JoonSJPK/analog_NN/dig_ana_sim_out/analog_NN_cross_domain_report.html

# analog_NN — simulation report

## Project Overview & Topology

Project | analog_NN
Components | 241 total (29 analog-bound, 64 AD5160, 53 resistors, 8 74HC595, 1 RP2040)
Nets | 194
Power rails | VCC=3.3 V, Vref=1.65 V (virtual ground)

## Firmware (RP2040)

Status | SKIPPED
Reason | No firmware ELF provided. User must supply a compiled RP2040 binary to run on Renode.
Note | Without firmware the shift chain and pot codes are set to defaults (code 128).

## Digital Domain — 74HC595 Shift Chain

Test | Shift 8 ones through 74HC595 cascade
Signals tracked | 277
Outputs asserted high | 49
Interpretation | Shift chain is connected and functional; 49 outputs assert from 8 bits shifted through a multi-stage serial-to-parallel topology.

## Analog Domain — Static Operating Point (.op) PASS

Analysis | .op
Converged | Yes
Pots modeled | 64 (AD5160 default code=128)
VCC | 3.30 V
Vref | 1.65 V
Status | Board biases correctly at mid-rail virtual ground.

## Analog Domain — Transient (.tran 100µ 5ms) PASS

Analysis | .tran 100u 5m
Converged | Yes
Duration | 5 ms simulated
Status | Full-board transient simulation converged cleanly.

## MVM Primitive Verification — Linear Range PASS

Test 1 (codes [120,200,64], inputs [1.8,1.5,1.7]) | Ideal=1.3293 V, SPICE=1.3292 V, error=0.11 mV, NOT clamped
Test 2 (codes [180,90,32], inputs [1.6,1.7,1.55]) | Ideal=2.344 V, SPICE=2.3437 V, error=0.30 mV, NOT clamped
Conclusion | Sub-millivolt accuracy when operating within linear range (mid codes ~32-224, inputs within ~0.3 V of 1.65 V virtual ground).
Status | Analog MVM primitive matches numpy ideal to < 1 mV.

## MVM Primitive — Intentional Clamping Check PASS

Test (codes [0,5,10], inputs [0.1,0.1,0.1]) | Ideal=355.09 V (unbounded), SPICE=3.2536 V (clamped), error=31.4 mV, CLAMPED=true
Interpretation | Code 0 = 60 Ω minimum resistance creates large current; 0.1 V input far from 1.65 V virtual ground forces rail-to-rail saturation. This is expected op-amp clamping, NOT a defect.
Notes | The TLV9061 output naturally saturates near the supply rails for extreme conductance or input-deviation combinations. For valid analog compute, keep codes in 32-224 and inputs within 0.3 V of Vref.
