JoonSJPK/analog_NN/dig_ana_sim_out/analog_NN_multidomain_report.html

# analog_NN — simulation report

## Project Discovery

Board | analog_NN
Components | 241 (64 AD5160 pots, 29 TLV9061 op-amps, 8×74HC595, 1 RP2040)
Nets | 194
Analog (bound) | 29 TLV9061 op-amps
Analog (unmodeled) | 64 AD5160 pots, 53 resistors, 82 caps, etc.
Digital | 8× 74HC595 shift registers
Firmware | RP2040 (U40)

## Digital Shift Chain (74HC595) PASS

Test | Shift 8 ones through 8× 74HC595
Total outputs | 277
Outputs high | 49
Verdict | Shift chain functional

## Firmware (RP2040) FAIL

Target | U40 (RP2040)
ELF | firmware/analog_NN.elf
Status | TIMEOUT after 300 s — Renode environment or ELF path issue
Recommendation | Verify ELF path, renode .resc script, and machine definition

## Analog Board (ngspice .tran) PASS

Analysis | .tran 1u 2m, default_code=128
Converged | Yes
VCC | 3.3 V
Vref | 1.65 V
Pots modeled | 64 (all)

## MVM Crossbar Verification (AD5160 + TLV9061 TIA) FAIL

Test 1 — codes=[128,128,128,128], Vin=[0.5,0.5,0.5,0.5] | Ideal=10.74 V, Clamped ideal=3.285 V, SPICE=3.2605 V, err=24.5 mV → CLAMPED
Test 2 — codes=[64,64,64,64], Vin=[0.2,0.2,0.2,0.2] | Ideal=24.31 V, Clamped=3.285 V, SPICE=3.256 V, err=28.7 mV → CLAMPED
Test 3 — codes=[200,50,200,50], Vin=[0.3,0.7,0.3,0.7] | Ideal=14.52 V, Clamped=3.285 V, SPICE=3.261 V, err=24.5 mV → CLAMPED
Test 4 — codes=[255,0,255,0], Vin=[0.1,1.0,0.1,1.0] | Ideal=221.4 V, Clamped=3.285 V, SPICE=3.262 V, err=22.6 mV → CLAMPED
Test 5 — codes=[16,16,16,16], Vin=[0.05,0.05,0.05,0.05] | Ideal=95.1 V, Clamped=3.285 V, SPICE=3.254 V, err=31.5 mV → CLAMPED
Test 6 — codes=[1], Vin=[0.001] | Ideal=168.1 V, Clamped=3.285 V, SPICE=3.253 V, err=32.2 mV → CLAMPED
Test 7 — codes=[0], Vin=[0.5] | Ideal=193.3 V, Clamped=3.285 V, SPICE=3.258 V, err=27.4 mV → CLAMPED

## Diagnosis: Pervasive Op-Amp Clipping FAIL

Observation | Every tested (codes, Vin) combination produces Vout ≈ 3.25-3.26 V — the TLV9061 positive rail (3.3 V) with ~50 mV headroom.
Root cause | The TIA feedback resistor (Rf) is extremely large relative to the AD5160 wiper resistance (Rw). Even Rw_min (code=0) with Vin=1 mV produces an ideal output >160 V, far exceeding the 3.3 V supply.
Implication | The crossbar operates in hard saturation for ALL practical inputs. The MVM is non-functional as a linear computation — it only outputs rail voltage.
Fix needed | Reduce Rf by 100–1000×, or reduce input voltage range, or increase VCC (TLV9061 supports up to 5.5 V) but fundamental gain is still too high.
