JoonSJPK/analog_NN/dig_ana_sim_out/report.html

# analog_NN — simulation report

## Design

components | 241
nets | 194
analog op-amps (modeled) | 29
analog unmodeled (pots etc.) | 67
digital ICs | 9
firmware (MCU) | U40

## Analog (ngspice, full board) PASS

pots modeled | 64
converged | True
vcc | 3.3
vref | 1.65

## Digital (Icarus Verilog, 74HC595 chain) PASS

signals | 277
outputs asserted | 238

## Analog compute vs numpy ideal (MVM) PASS

ideal | 1.3293
spice | 1.3292
error (mV) | 0.11
