JoonSJPK/analog_NN/analog_NN_JLCPCB_BOM.csv

Comment | Designator | Footprint | JLC_Class | LCSC_Candidate_VERIFY | Notes
100nF 50V X7R | C1,C2,C3,C4,C5,C6,C7,C8,C9,C10,C11,C12,C13,C14,C15,C16,C17,C18,C19,C20,C21,C22,C23,C24,C25,C26,C27,C28,C29,C30,C31,C32,C33,C34,C35,C36,C37,C38,C39,C40,C41,C42,C43,C44,C45,C46,C47,C48,C49,C50,C51,C52,C53,C54,C55,C56,C57,C58,C59,C60,C61,C62,C63,C64,C65,C66,C67,C68,C70 | C1206 | Basic | C29823 | Verify: 1206 100nF X7R Basic part
1uF 25V X7R | C69 | C1206 | Basic | C15849 | Verify 1206 1uF X7R
10k 1% | R1,R2,R3,R4,R5,R6,R7,R8,R9,R10,R11,R12,R13,R14,R15,R16,R17,R18,R19,R20,R21,R22,R23,R24,R25,R26,R27,R28,R29,R30,R31,R32,R33,R34,R35,R36,R37,R38,R39,R40,R41,R42,R43,R48,R49 | R1206 | Basic | C17888 | Verify 1206 10k 1%
10M 1% | R44,R45,R46,R47 | R1206 | Basic | C112094 | Verify 1206 10M 1%
TLV9061IDBVR | U1,U3,U4,U5,U6,U7,U8,U9,U10,U11,U12,U13,U14,U15,U16,U17,U18,U19,U20,U21,U22,U23,U24,U25,U26,U27,U43,U132 | SOT-23-5 | Extended | C398358 | VERIFIED in stock. 29 pcs. NOTE: 27 have blank value in sch (U1-U27) - set to TLV9061IDBVR
AD5160BRJZ10-RL7 | U28,U29,U30,U31,U32,U33,U34,U35,U60,U61,U62,U63,U64,U65,U66,U67,U68,U69,U70,U71,U72,U73,U74,U75,U76,U77,U78,U79,U80,U81,U82,U83,U100,U101,U102,U103,U104,U105,U106,U107,U108,U109,U110,U111,U112,U113,U114,U115,U116,U117,U118,U119,U120,U121,U122,U123,U124,U125,U126,U127,U128,U129,U130,U131 | SOT-23-8 | Extended | C40097 | VERIFIED ~5295 in stock (~$1.37). 10k variant. 100k variant = C578141. 64 pcs/board
SN74HC595DR | U36,U37,U38,U39,U93,U94,U95,U96 | SOIC-16 | Basic | C5947 | VERIFIED Basic (Nexperia 74HC595D). TI SN74HC595DR = C10092
