JoonSJPK/analog_NN/dig_ana_sim_out/netlist/analog_NN.cir

.title KiCad schematic
.include "/Users/joon/Projects/Wim/analog_NN/TLV9061_generic.lib"
C78 Net-_U42-EN_ GND 10u
U42 __U42
J1 __J1
R48 Net-_J1-CC1_ GND 5.1k
R49 Net-_J1-CC2_ GND 5.1k
C80 Net-_U42-EN_ GND 1u
C81 GND VREF 10u
U40 __U40
R51 Net-_C75-Pad1_ Net-_U40-XOUT_ 1k
Y1 __Y1
C75 Net-_C75-Pad1_ GND 15p
XU2 VREF GND Net-_U2-+_ VREF VCC TLV9061
C70 GND VCC 100n
U41 __U41
C76 Net-_U40-XIN_ GND 15p
R53 Net-_U2-+_ GND 10k
C77 Net-_U42-BP_ GND 470p
C79 VCC GND 10u
C82 GND Net-_U2-+_ 100n
R52 VCC Net-_U2-+_ 10k
C69 GND Net-_U40-VREG_VOUT_ 1u
R50 Net-_U40-RUN_ VCC 10k
C72 GND VCC 100n
C71 GND VCC 100n
C73 GND VCC 100n
C74 GND VCC 100n
R12 Net-_U6--_ Vh3 10k
XU7 -Vh4 GND VREF Net-_U7--_ VCC TLV9061
R14 Net-_U7--_ Vh4 10k
R13 -Vh4 Net-_U7--_ 10k
XU6 -Vh3 GND VREF Net-_U6--_ VCC TLV9061
XU4 -Vh1 GND VREF Net-_U4--_ VCC TLV9061
XU3 -Vu3 GND VREF Net-_U3--_ VCC TLV9061
R6 Net-_U3--_ Vin_u3 10k
R7 -Vh1 Net-_U4--_ 10k
R5 -Vu3 Net-_U3--_ 10k
R8 Net-_U4--_ Vh1 10k
R2 Net-_U1--_ Vin_u2 10k
R1 -Vu2 Net-_U1--_ 10k
XU43 -Vu1 GND VREF Net-_U43--_ VCC TLV9061
R3 -Vu1 Net-_U43--_ 10k
XU1 -Vu2 GND VREF Net-_U1--_ VCC TLV9061
R4 Net-_U43--_ Vin_u1 10k
R11 -Vh3 Net-_U6--_ 10k
XU5 -Vh2 GND VREF Net-_U5--_ VCC TLV9061
R10 Net-_U5--_ Vh2 10k
R9 -Vh2 Net-_U5--_ 10k
C22 VCC GND 100n
U77 __U77
U73 __U73
U72 __U72
C19 VCC GND 100n
C20 VCC GND 100n
C28 VCC GND 100n
U76 __U76
C21 VCC GND 100n
U80 __U80
C27 VCC GND 100n
U81 __U81
C15 VCC GND 100n
U70 __U70
C10 VCC GND 100n
U66 __U66
C7 VCC GND 100n
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
U30 __U30
U29 __U29
C61 VCC GND 100n
C68 VCC GND 100n
U28 __U28
C64 VCC GND 100n
C65 VCC GND 100n
U35 __U35
XU92 torque GND VREF Net-_U28-A_ VCC TLV9061
R43 Net-_U28-A_ torque 10k
C63 VCC GND 100n
U32 __U32
U37 __U37
U38 __U38
U39 __U39
U36 __U36
U93 __U93
U94 __U94
U95 __U95
U96 __U96
.end
