JoonSJPK/analog_NN/analog_NN.kicad_pcb

## KiCad design analog_NN.kicad_pcb (2026-08-01)

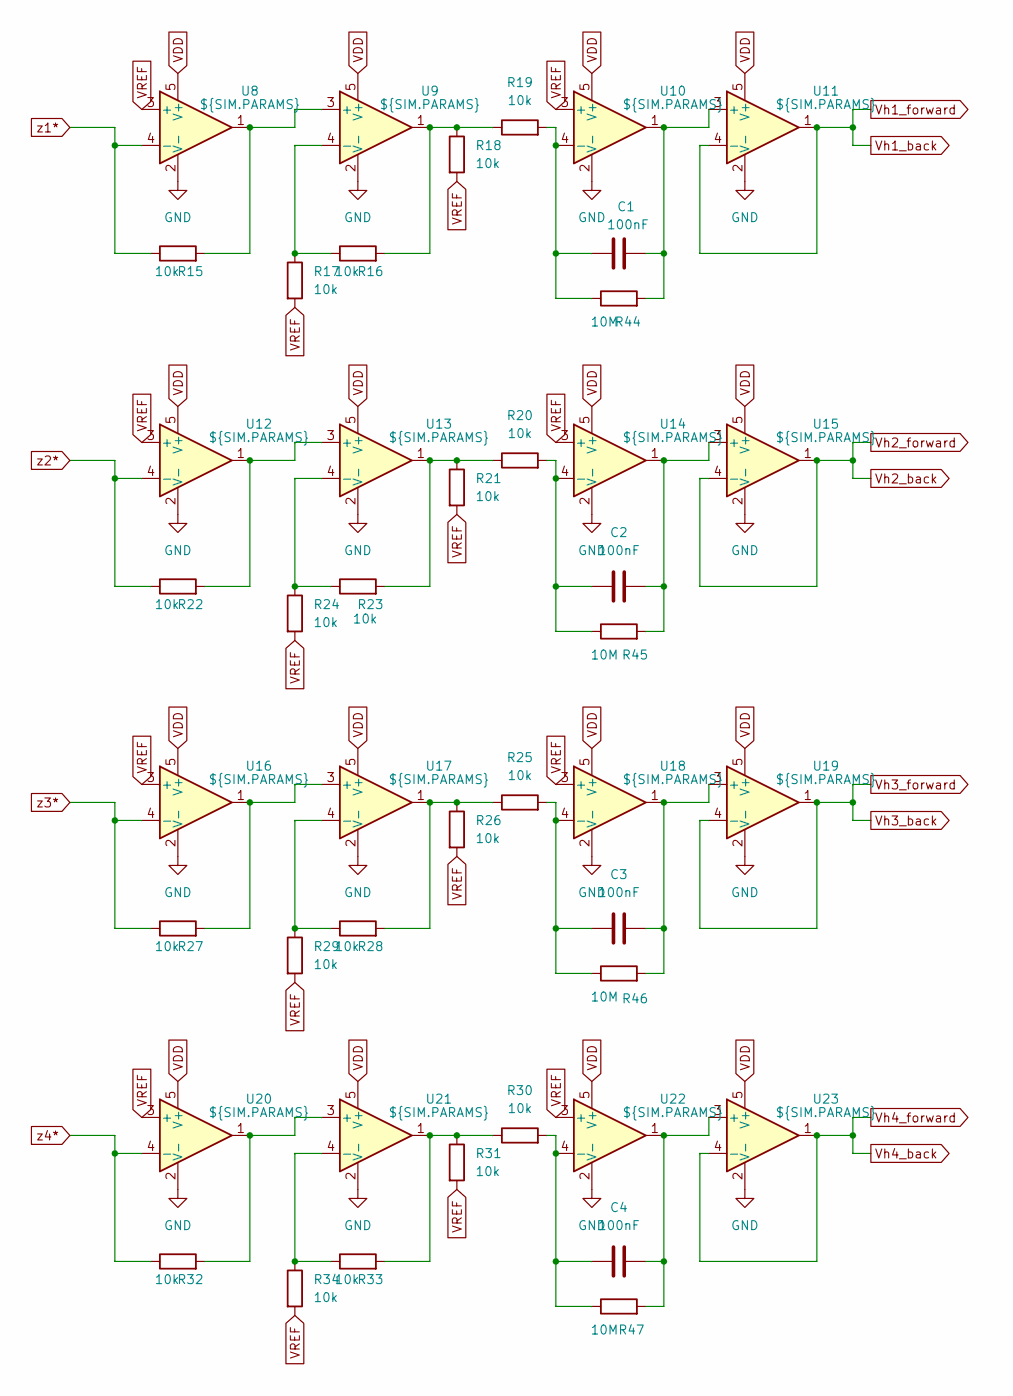
[picture p1: schematic op_amps.kicad_sch]

Parts:
C1, C2, C3, C4: 100nF; C_1206_3216Metric
R15, R16, R17, R18, R19, R20, R21, R22, R23, R24, R25, R26, R27, R28, R29, R30, R31, R32, R33, R34: 10k; R_1206_3216Metric
R44, R45, R46, R47: 10M; R_1206_3216Metric
U8, U9, U10, U11, U12, U13, U14, U15, U16, U17, U18, U19, U20, U21, U22, U23: ${SIM.PARAMS}; SOT-23-5

Connections:
GND: U8.2 (V-), U9.2 (V-), U10.2 (V-), U11.2 (V-), U12.2 (V-), U13.2 (V-), U14.2 (V-), U15.2 (V-), U16.2 (V-), U17.2 (V-), U18.2 (V-), U19.2 (V-), U20.2 (V-), U21.2 (V-), U22.2 (V-), U23.2 (V-); also elsewhere on the board
unnamed: R16.2, R18.1, R19.1, U9.1
unnamed: R20.1, R21.1, R23.2, U13.1
unnamed: R25.1, R26.1, R28.2, U17.1
unnamed: R30.1, R31.1, R33.2, U21.1
unnamed: R15.2, U8.1, U9.3 (+)
unnamed: R16.1, R17.1, U9.4 (-)
unnamed: C1.1, R19.2, R44.1, U10.4 (-)
unnamed: C1.2, R44.2, U10.1, U11.3 (+)
unnamed: R22.2, U12.1, U13.3 (+)
unnamed: R23.1, R24.1, U13.4 (-)
unnamed: C2.1, R20.2, R45.1, U14.4 (-)
unnamed: C2.2, R45.2, U14.1, U15.3 (+)
unnamed: R27.2, U16.1, U17.3 (+)
unnamed: R28.1, R29.1, U17.4 (-)
unnamed: C3.1, R25.2, R46.1, U18.4 (-)
unnamed: C3.2, R46.2, U18.1, U19.3 (+)
unnamed: R32.2, U20.1, U21.3 (+)
unnamed: R33.1, R34.1, U21.4 (-)
unnamed: C4.1, R30.2, R47.1, U22.4 (-)
unnamed: C4.2, R47.2, U22.1, U23.3 (+)
VDD: U8.5 (V+), U9.5 (V+), U10.5 (V+), U11.5 (V+), U12.5 (V+), U13.5 (V+), U14.5 (V+), U15.5 (V+), U16.5 (V+), U17.5 (V+), U18.5 (V+), U19.5 (V+), U20.5 (V+), U21.5 (V+), U22.5 (V+), U23.5 (V+); also elsewhere on the board
VREF: R17.2, R18.2, R21.2, R24.2, R26.2, R29.2, R31.2, R34.2, U8.3 (+), U10.3 (+), U12.3 (+), U14.3 (+), U16.3 (+), U18.3 (+), U20.3 (+), U22.3 (+); also elsewhere on the board
Vh1: U11.1, U11.4 (-); also elsewhere on the board
Vh2: U15.1, U15.4 (-); also elsewhere on the board
Vh3: U19.1, U19.4 (-); also elsewhere on the board
Vh4: U23.1, U23.4 (-); also elsewhere on the board
cbar1: R15.1, U8.4 (-); also elsewhere on the board
cbar2: R22.1, U12.4 (-); also elsewhere on the board
cbar3: R27.1, U16.4 (-); also elsewhere on the board
cbar4: R32.1, U20.4 (-); also elsewhere on the board

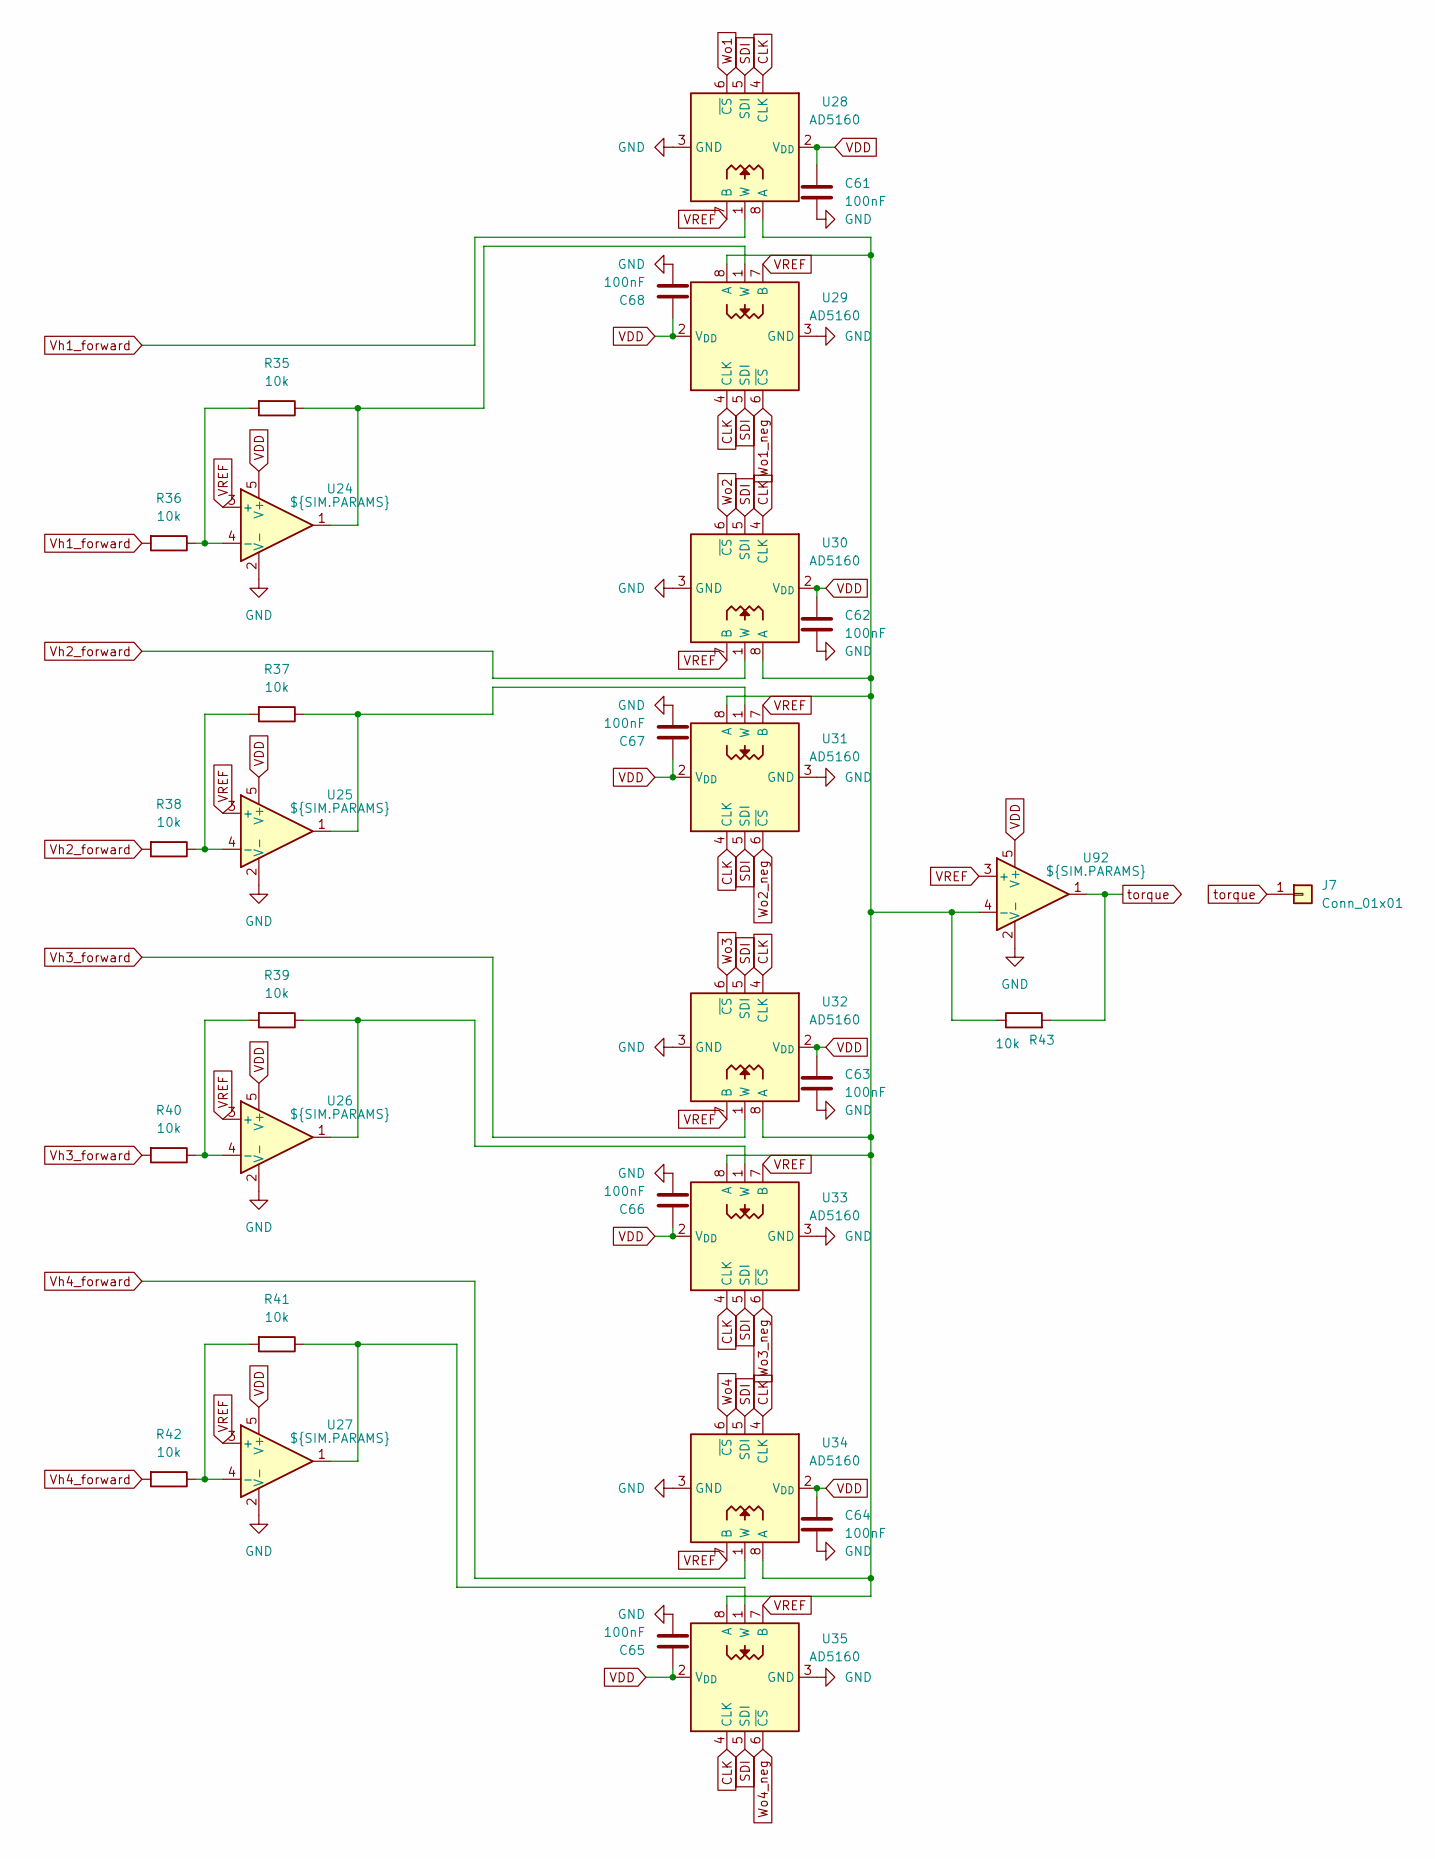
[picture p2: schematic torque.kicad_sch]

Parts:
C61, C62, C63, C64, C65, C66, C67, C68: 100nF; C_1206_3216Metric
J7: Conn_01x01; WireSolderPad_1.0mm
R35, R36, R37, R38, R39, R40, R41, R42, R43: 10k; R_1206_3216Metric
U24, U25, U26, U27, U92: ${SIM.PARAMS}; SOT-23-5
U28, U29, U30, U31, U32, U33, U34, U35: AD5160; SOT-23-8

Connections:
CLK: U28.4 (CLK), U29.4 (CLK), U30.4 (CLK), U31.4 (CLK), U32.4 (CLK), U33.4 (CLK), U34.4 (CLK), U35.4 (CLK); also elsewhere on the board
GND: C61.2, C62.2, C63.2, C64.2, C65.2, C66.2, C67.2, C68.2, U24.2 (V-), U25.2 (V-), U26.2 (V-), U27.2 (V-), U28.3 (GND), U29.3 (GND), U30.3 (GND), U31.3 (GND), U32.3 (GND), U33.3 (GND), U34.3 (GND), U35.3 (GND), U92.2 (V-); also elsewhere on the board
unnamed: R35.2, R36.1, U24.4 (-)
unnamed: R37.2, R38.1, U25.4 (-)
unnamed: R39.2, R40.1, U26.4 (-)
unnamed: R41.2, R42.1, U27.4 (-)
unnamed: R43.1, U28.8 (A), U29.8 (A), U30.8 (A), U31.8 (A), U32.8 (A), U33.8 (A), U34.8 (A), U35.8 (A), U92.4 (-)
unnamed: R35.1, U24.1, U29.1 (W)
unnamed: R37.1, U25.1, U31.1 (W)
unnamed: R39.1, U26.1, U33.1 (W)
unnamed: R41.1, U27.1, U35.1 (W)
SDI: U28.5 (SDI), U29.5 (SDI), U30.5 (SDI), U31.5 (SDI), U32.5 (SDI), U33.5 (SDI), U34.5 (SDI), U35.5 (SDI); also elsewhere on the board
VDD: C61.1, C62.1, C63.1, C64.1, C65.1, C66.1, C67.1, C68.1, U24.5 (V+), U25.5 (V+), U26.5 (V+), U27.5 (V+), U28.2 (V_{DD}), U29.2 (V_{DD}), U30.2 (V_{DD}), U31.2 (V_{DD}), U32.2 (V_{DD}), U33.2 (V_{DD}), U34.2 (V_{DD}), U35.2 (V_{DD}), U92.5 (V+); also elsewhere on the board
VREF: U24.3 (+), U25.3 (+), U26.3 (+), U27.3 (+), U28.7 (B), U29.7 (B), U30.7 (B), U31.7 (B), U32.7 (B), U33.7 (B), U34.7 (B), U35.7 (B), U92.3 (+); also elsewhere on the board
Vh1_forward: R36.2, U28.1 (W)
Vh2_forward: R38.2, U30.1 (W)
Vh3_forward: R40.2, U32.1 (W)
Vh4_forward: R42.2, U34.1 (W)
Wo1: U28.6 (~CS); also elsewhere on the board
Wo1_neg: U29.6 (~CS); also elsewhere on the board
Wo2: U30.6 (~CS); also elsewhere on the board
Wo2_neg: U31.6 (~CS); also elsewhere on the board
Wo3: U32.6 (~CS); also elsewhere on the board
Wo3_neg: U33.6 (~CS); also elsewhere on the board
Wo4: U34.6 (~CS); also elsewhere on the board
Wo4_neg: U35.6 (~CS); also elsewhere on the board
torque: J7.1, R43.2, U92.1

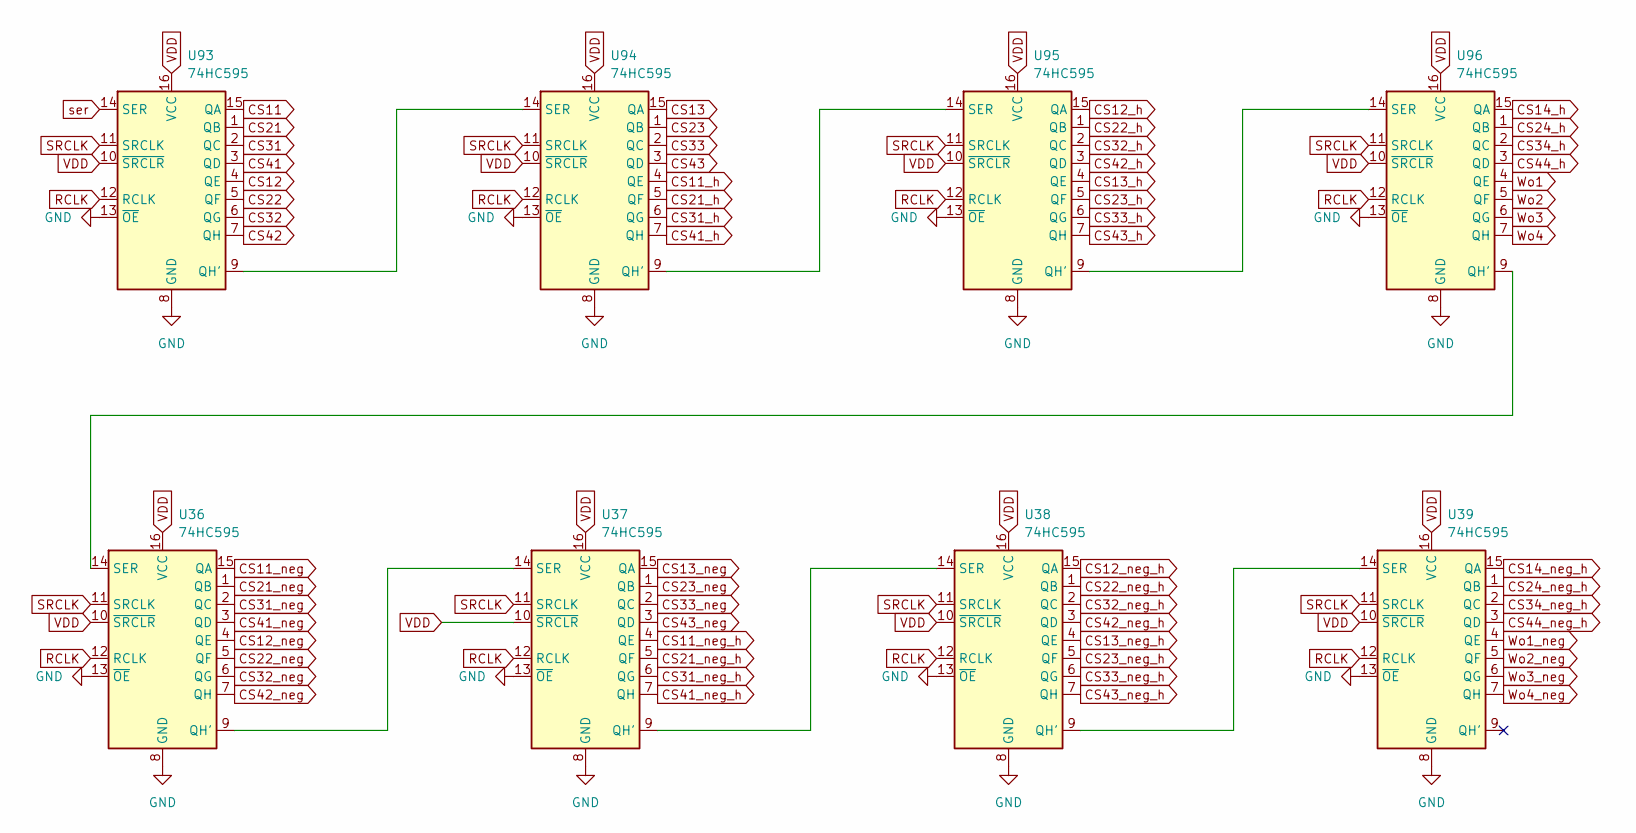
[picture p3: schematic shift_register_chain.kicad_sch]

Parts:
U36, U37, U38, U39, U93, U94, U95, U96: 74HC595; SOIC-16_3.9x9.9mm_P1.27mm

Connections:
CS11: U93.15 (QA); also elsewhere on the board
CS11_h: U94.4 (QE); also elsewhere on the board
CS11_neg: U36.15 (QA); also elsewhere on the board
CS11_neg_h: U37.4 (QE); also elsewhere on the board
CS12: U93.4 (QE); also elsewhere on the board
CS12_h: U95.15 (QA); also elsewhere on the board
CS12_neg: U36.4 (QE); also elsewhere on the board
CS12_neg_h: U38.15 (QA); also elsewhere on the board
CS13: U94.15 (QA); also elsewhere on the board
CS13_h: U95.4 (QE); also elsewhere on the board
CS13_neg: U37.15 (QA); also elsewhere on the board
CS13_neg_h: U38.4 (QE); also elsewhere on the board
CS14_h: U96.15 (QA); also elsewhere on the board
CS14_neg_h: U39.15 (QA); also elsewhere on the board
CS21: U93.1 (QB); also elsewhere on the board
CS21_h: U94.5 (QF); also elsewhere on the board
CS21_neg: U36.1 (QB); also elsewhere on the board
CS21_neg_h: U37.5 (QF); also elsewhere on the board
CS22: U93.5 (QF); also elsewhere on the board
CS22_h: U95.1 (QB); also elsewhere on the board
CS22_neg: U36.5 (QF); also elsewhere on the board
CS22_neg_h: U38.1 (QB); also elsewhere on the board
CS23: U94.1 (QB); also elsewhere on the board
CS23_h: U95.5 (QF); also elsewhere on the board
CS23_neg: U37.1 (QB); also elsewhere on the board
CS23_neg_h: U38.5 (QF); also elsewhere on the board
CS24_h: U96.1 (QB); also elsewhere on the board
CS24_neg_h: U39.1 (QB); also elsewhere on the board
CS31: U93.2 (QC); also elsewhere on the board
CS31_h: U94.6 (QG); also elsewhere on the board
CS31_neg: U36.2 (QC); also elsewhere on the board
CS31_neg_h: U37.6 (QG); also elsewhere on the board
CS32: U93.6 (QG); also elsewhere on the board
CS32_h: U95.2 (QC); also elsewhere on the board
CS32_neg: U36.6 (QG); also elsewhere on the board
CS32_neg_h: U38.2 (QC); also elsewhere on the board
CS33: U94.2 (QC); also elsewhere on the board
CS33_h: U95.6 (QG); also elsewhere on the board
CS33_neg: U37.2 (QC); also elsewhere on the board
CS33_neg_h: U38.6 (QG); also elsewhere on the board
CS34_h: U96.2 (QC); also elsewhere on the board
CS34_neg_h: U39.2 (QC); also elsewhere on the board
CS41: U93.3 (QD); also elsewhere on the board
CS41_h: U94.7 (QH); also elsewhere on the board
CS41_neg: U36.3 (QD); also elsewhere on the board
CS41_neg_h: U37.7 (QH); also elsewhere on the board
CS42: U93.7 (QH); also elsewhere on the board
CS42_h: U95.3 (QD); also elsewhere on the board
CS42_neg: U36.7 (QH); also elsewhere on the board
CS42_neg_h: U38.3 (QD); also elsewhere on the board
CS43: U94.3 (QD); also elsewhere on the board
CS43_h: U95.7 (QH); also elsewhere on the board
CS43_neg: U37.3 (QD); also elsewhere on the board
CS43_neg_h: U38.7 (QH); also elsewhere on the board
CS44_h: U96.3 (QD); also elsewhere on the board
CS44_neg_h: U39.3 (QD); also elsewhere on the board
GND: U36.8 (GND), U36.13 (~OE), U37.8 (GND), U37.13 (~OE), U38.8 (GND), U38.13 (~OE), U39.8 (GND), U39.13 (~OE), U93.8 (GND), U93.13 (~OE), U94.8 (GND), U94.13 (~OE), U95.8 (GND), U95.13 (~OE), U96.8 (GND), U96.13 (~OE); also elsewhere on the board
unnamed: U36.9 (QH'), U37.14 (SER)
unnamed: U36.14 (SER), U96.9 (QH')
unnamed: U37.9 (QH'), U38.14 (SER)
unnamed: U38.9 (QH'), U39.14 (SER)
unnamed: U93.9 (QH'), U94.14 (SER)
unnamed: U94.9 (QH'), U95.14 (SER)
unnamed: U95.9 (QH'), U96.14 (SER)
RCLK: U36.12 (RCLK), U37.12 (RCLK), U38.12 (RCLK), U39.12 (RCLK), U93.12 (RCLK), U94.12 (RCLK), U95.12 (RCLK), U96.12 (RCLK); also elsewhere on the board
SRCLK: U36.11 (SRCLK), U37.11 (SRCLK), U38.11 (SRCLK), U39.11 (SRCLK), U93.11 (SRCLK), U94.11 (SRCLK), U95.11 (SRCLK), U96.11 (SRCLK); also elsewhere on the board
VDD: U36.10 (~SRCLR), U36.16 (VCC), U37.10 (~SRCLR), U37.16 (VCC), U38.10 (~SRCLR), U38.16 (VCC), U39.10 (~SRCLR), U39.16 (VCC), U93.10 (~SRCLR), U93.16 (VCC), U94.10 (~SRCLR), U94.16 (VCC), U95.10 (~SRCLR), U95.16 (VCC), U96.10 (~SRCLR), U96.16 (VCC); also elsewhere on the board
Wo1: U96.4 (QE); also elsewhere on the board
Wo1_neg: U39.4 (QE); also elsewhere on the board
Wo2: U96.5 (QF); also elsewhere on the board
Wo2_neg: U39.5 (QF); also elsewhere on the board
Wo3: U96.6 (QG); also elsewhere on the board
Wo3_neg: U39.6 (QG); also elsewhere on the board
Wo4: U96.7 (QH); also elsewhere on the board
Wo4_neg: U39.7 (QH); also elsewhere on the board
ser: U93.14 (SER); also elsewhere on the board

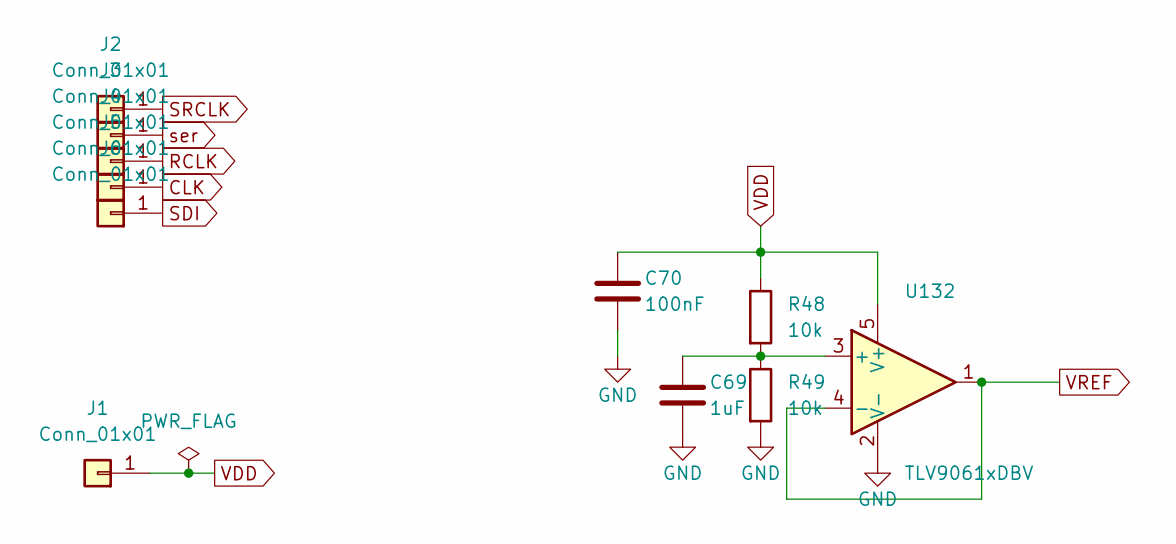
[picture p4: schematic power_ext.kicad_sch]

Parts:
C69: 1uF; C_1206_3216Metric_Pad1.33x1.80mm_HandSolder
C70: 100nF; C_1206_3216Metric_Pad1.33x1.80mm_HandSolder
J1, J2, J3, J4, J5, J6: Conn_01x01; WireSolderPad_1.0mm
R48, R49: 10k; R_1206_3216Metric_Pad1.30x1.75mm_HandSolder
U132: TLV9061xDBV; SOT-23-5

Connections:
GND: C69.2, C70.2, R49.2, U132.2 (V-); also elsewhere on the board
unnamed: C69.1, R48.2, R49.1, U132.3 (+)
RCLK: J4.1; also elsewhere on the board
SRCLK: J2.1; also elsewhere on the board
VDD: C70.1, J1.1, R48.1, U132.5 (V+); also elsewhere on the board
VREF: U132.1, U132.4 (-); also elsewhere on the board
ser: J3.1; also elsewhere on the board

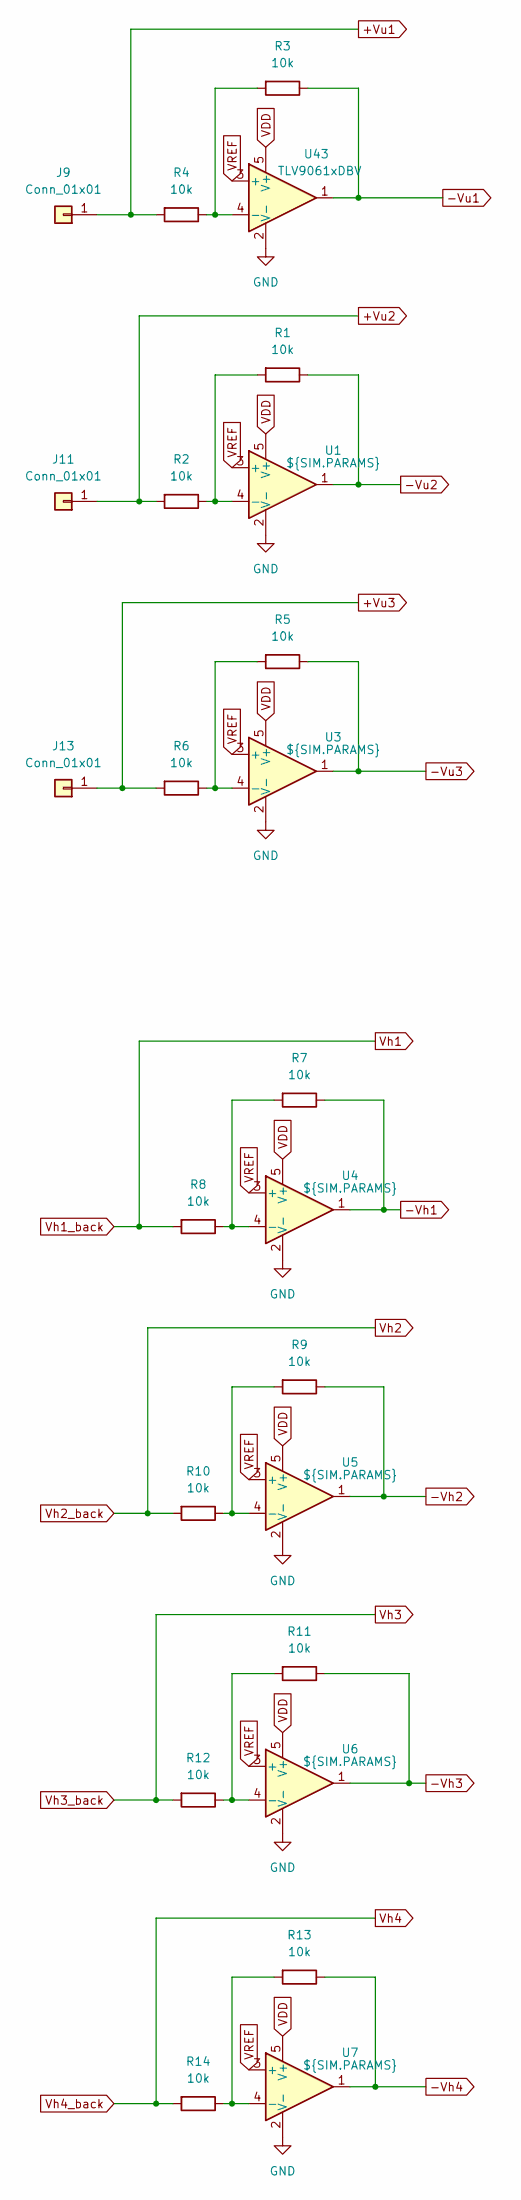
[picture p5: schematic u_input.kicad_sch]

Parts:
J9, J11, J13: Conn_01x01; WireSolderPad_1.0mm
R1, R2, R3, R4, R5, R6, R7, R8, R9, R10, R11, R12, R13, R14: 10k; R_1206_3216Metric
U1, U3, U4, U5, U6, U7: ${SIM.PARAMS}; SOT-23-5
U43: TLV9061xDBV; SOT-23-5

Connections:
-Vh1: R7.1, U4.1; also elsewhere on the board
-Vh2: R9.1, U5.1; also elsewhere on the board
-Vh3: R11.1, U6.1; also elsewhere on the board
-Vh4: R13.1, U7.1; also elsewhere on the board
-Vu1: R3.1, U43.1; also elsewhere on the board
-Vu2: R1.1, U1.1; also elsewhere on the board
-Vu3: R5.1, U3.1; also elsewhere on the board
GND: U1.2 (V-), U3.2 (V-), U4.2 (V-), U5.2 (V-), U6.2 (V-), U7.2 (V-), U43.2 (V-); also elsewhere on the board
unnamed: R1.2, R2.1, U1.4 (-)
unnamed: R5.2, R6.1, U3.4 (-)
unnamed: R7.2, R8.1, U4.4 (-)
unnamed: R9.2, R10.1, U5.4 (-)
unnamed: R11.2, R12.1, U6.4 (-)
unnamed: R13.2, R14.1, U7.4 (-)
unnamed: R3.2, R4.1, U43.4 (-)
VDD: U1.5 (V+), U3.5 (V+), U4.5 (V+), U5.5 (V+), U6.5 (V+), U7.5 (V+), U43.5 (V+); also elsewhere on the board
VREF: U1.3 (+), U3.3 (+), U4.3 (+), U5.3 (+), U6.3 (+), U7.3 (+), U43.3 (+); also elsewhere on the board
Vh1: R8.2; also elsewhere on the board
Vh2: R10.2; also elsewhere on the board
Vh3: R12.2; also elsewhere on the board
Vh4: R14.2; also elsewhere on the board
Vu1: J9.1, R4.2; also elsewhere on the board
Vu2: J11.1, R2.2; also elsewhere on the board
Vu3: J13.1, R6.2; also elsewhere on the board

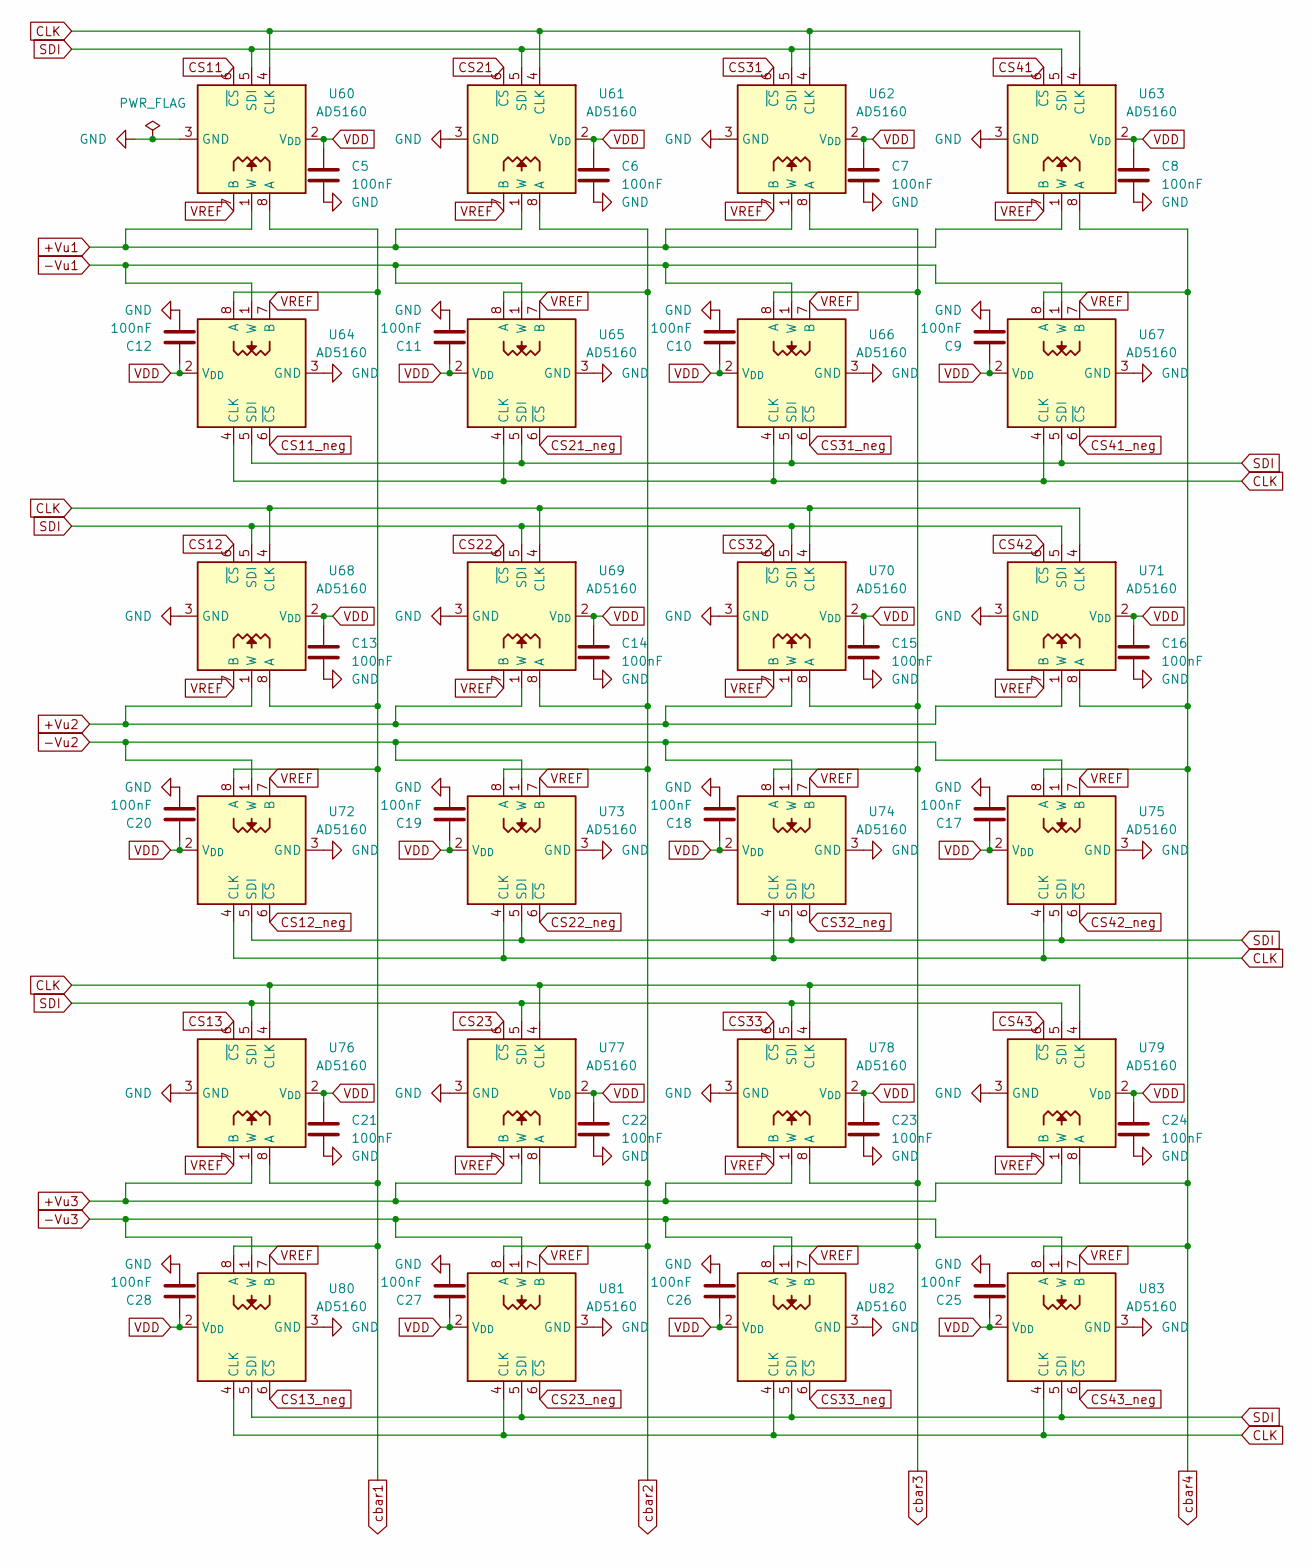
[picture p6: schematic crossbar_u.kicad_sch]

Parts:
C5, C6, C7, C8, C9, C10, C11, C12, C13, C14, C15, C16, C17, C18, C19, C20, C21, C22, C23, C24, C25, C26, C27, C28: 100nF; C_1206_3216Metric
U60, U61, U62, U63, U64, U65, U66, U67, U68, U69, U70, U71, U72, U73, U74, U75, U76, U77, U78, U79, U80, U81, U82, U83: AD5160; SOT-23-8

Connections:
+Vu1: U60.1 (W), U61.1 (W), U62.1 (W), U63.1 (W)
+Vu2: U68.1 (W), U69.1 (W), U70.1 (W), U71.1 (W)
+Vu3: U76.1 (W), U77.1 (W), U78.1 (W), U79.1 (W)
-Vu1: U64.1 (W), U65.1 (W), U66.1 (W), U67.1 (W); also elsewhere on the board
-Vu2: U72.1 (W), U73.1 (W), U74.1 (W), U75.1 (W); also elsewhere on the board
-Vu3: U80.1 (W), U81.1 (W), U82.1 (W), U83.1 (W); also elsewhere on the board
CLK: U60.4 (CLK), U61.4 (CLK), U62.4 (CLK), U63.4 (CLK), U64.4 (CLK), U65.4 (CLK), U66.4 (CLK), U67.4 (CLK), U68.4 (CLK), U69.4 (CLK), U70.4 (CLK), U71.4 (CLK), U72.4 (CLK), U73.4 (CLK), U74.4 (CLK), U75.4 (CLK), U76.4 (CLK), U77.4 (CLK), U78.4 (CLK), U79.4 (CLK), U80.4 (CLK), U81.4 (CLK), U82.4 (CLK), U83.4 (CLK); also elsewhere on the board
CS11: U60.6 (~CS); also elsewhere on the board
CS11_neg: U64.6 (~CS); also elsewhere on the board
CS12: U68.6 (~CS); also elsewhere on the board
CS12_neg: U72.6 (~CS); also elsewhere on the board
CS13: U76.6 (~CS); also elsewhere on the board
CS13_neg: U80.6 (~CS); also elsewhere on the board
CS21: U61.6 (~CS); also elsewhere on the board
CS21_neg: U65.6 (~CS); also elsewhere on the board
CS22: U69.6 (~CS); also elsewhere on the board
CS22_neg: U73.6 (~CS); also elsewhere on the board
CS23: U77.6 (~CS); also elsewhere on the board
CS23_neg: U81.6 (~CS); also elsewhere on the board
CS31: U62.6 (~CS); also elsewhere on the board
CS31_neg: U66.6 (~CS); also elsewhere on the board
CS32: U70.6 (~CS); also elsewhere on the board
CS32_neg: U74.6 (~CS); also elsewhere on the board
CS33: U78.6 (~CS); also elsewhere on the board
CS33_neg: U82.6 (~CS); also elsewhere on the board
CS41: U63.6 (~CS); also elsewhere on the board
CS41_neg: U67.6 (~CS); also elsewhere on the board
CS42: U71.6 (~CS); also elsewhere on the board
CS42_neg: U75.6 (~CS); also elsewhere on the board
CS43: U79.6 (~CS); also elsewhere on the board
CS43_neg: U83.6 (~CS); also elsewhere on the board
GND: C5.2, C6.2, C7.2, C8.2, C9.2, C10.2, C11.2, C12.2, C13.2, C14.2, C15.2, C16.2, C17.2, C18.2, C19.2, C20.2, C21.2, C22.2, C23.2, C24.2, C25.2, C26.2, C27.2, C28.2, U60.3 (GND), U61.3 (GND), U62.3 (GND), U63.3 (GND), U64.3 (GND), U65.3 (GND), U66.3 (GND), U67.3 (GND), U68.3 (GND), U69.3 (GND), U70.3 (GND), U71.3 (GND), U72.3 (GND), U73.3 (GND), U74.3 (GND), U75.3 (GND), U76.3 (GND), U77.3 (GND), U78.3 (GND), U79.3 (GND), U80.3 (GND), U81.3 (GND), U82.3 (GND), U83.3 (GND); also elsewhere on the board
SDI: U60.5 (SDI), U61.5 (SDI), U62.5 (SDI), U63.5 (SDI), U64.5 (SDI), U65.5 (SDI), U66.5 (SDI), U67.5 (SDI), U68.5 (SDI), U69.5 (SDI), U70.5 (SDI), U71.5 (SDI), U72.5 (SDI), U73.5 (SDI), U74.5 (SDI), U75.5 (SDI), U76.5 (SDI), U77.5 (SDI), U78.5 (SDI), U79.5 (SDI), U80.5 (SDI), U81.5 (SDI), U82.5 (SDI), U83.5 (SDI); also elsewhere on the board
VDD: C5.1, C6.1, C7.1, C8.1, C9.1, C10.1, C11.1, C12.1, C13.1, C14.1, C15.1, C16.1, C17.1, C18.1, C19.1, C20.1, C21.1, C22.1, C23.1, C24.1, C25.1, C26.1, C27.1, C28.1, U60.2 (V_{DD}), U61.2 (V_{DD}), U62.2 (V_{DD}), U63.2 (V_{DD}), U64.2 (V_{DD}), U65.2 (V_{DD}), U66.2 (V_{DD}), U67.2 (V_{DD}), U68.2 (V_{DD}), U69.2 (V_{DD}), U70.2 (V_{DD}), U71.2 (V_{DD}), U72.2 (V_{DD}), U73.2 (V_{DD}), U74.2 (V_{DD}), U75.2 (V_{DD}), U76.2 (V_{DD}), U77.2 (V_{DD}), U78.2 (V_{DD}), U79.2 (V_{DD}), U80.2 (V_{DD}), U81.2 (V_{DD}), U82.2 (V_{DD}), U83.2 (V_{DD}); also elsewhere on the board
VREF: U60.7 (B), U61.7 (B), U62.7 (B), U63.7 (B), U64.7 (B), U65.7 (B), U66.7 (B), U67.7 (B), U68.7 (B), U69.7 (B), U70.7 (B), U71.7 (B), U72.7 (B), U73.7 (B), U74.7 (B), U75.7 (B), U76.7 (B), U77.7 (B), U78.7 (B), U79.7 (B), U80.7 (B), U81.7 (B), U82.7 (B), U83.7 (B); also elsewhere on the board
cbar1: U60.8 (A), U64.8 (A), U68.8 (A), U72.8 (A), U76.8 (A), U80.8 (A); also elsewhere on the board
cbar2: U61.8 (A), U65.8 (A), U69.8 (A), U73.8 (A), U77.8 (A), U81.8 (A); also elsewhere on the board
cbar3: U62.8 (A), U66.8 (A), U70.8 (A), U74.8 (A), U78.8 (A), U82.8 (A); also elsewhere on the board
cbar4: U63.8 (A), U67.8 (A), U71.8 (A), U75.8 (A), U79.8 (A), U83.8 (A); also elsewhere on the board
