JoonSJPK/analog_NN/analog_NN.kicad_pcb

## KiCad design analog_NN.kicad_pcb (continued)

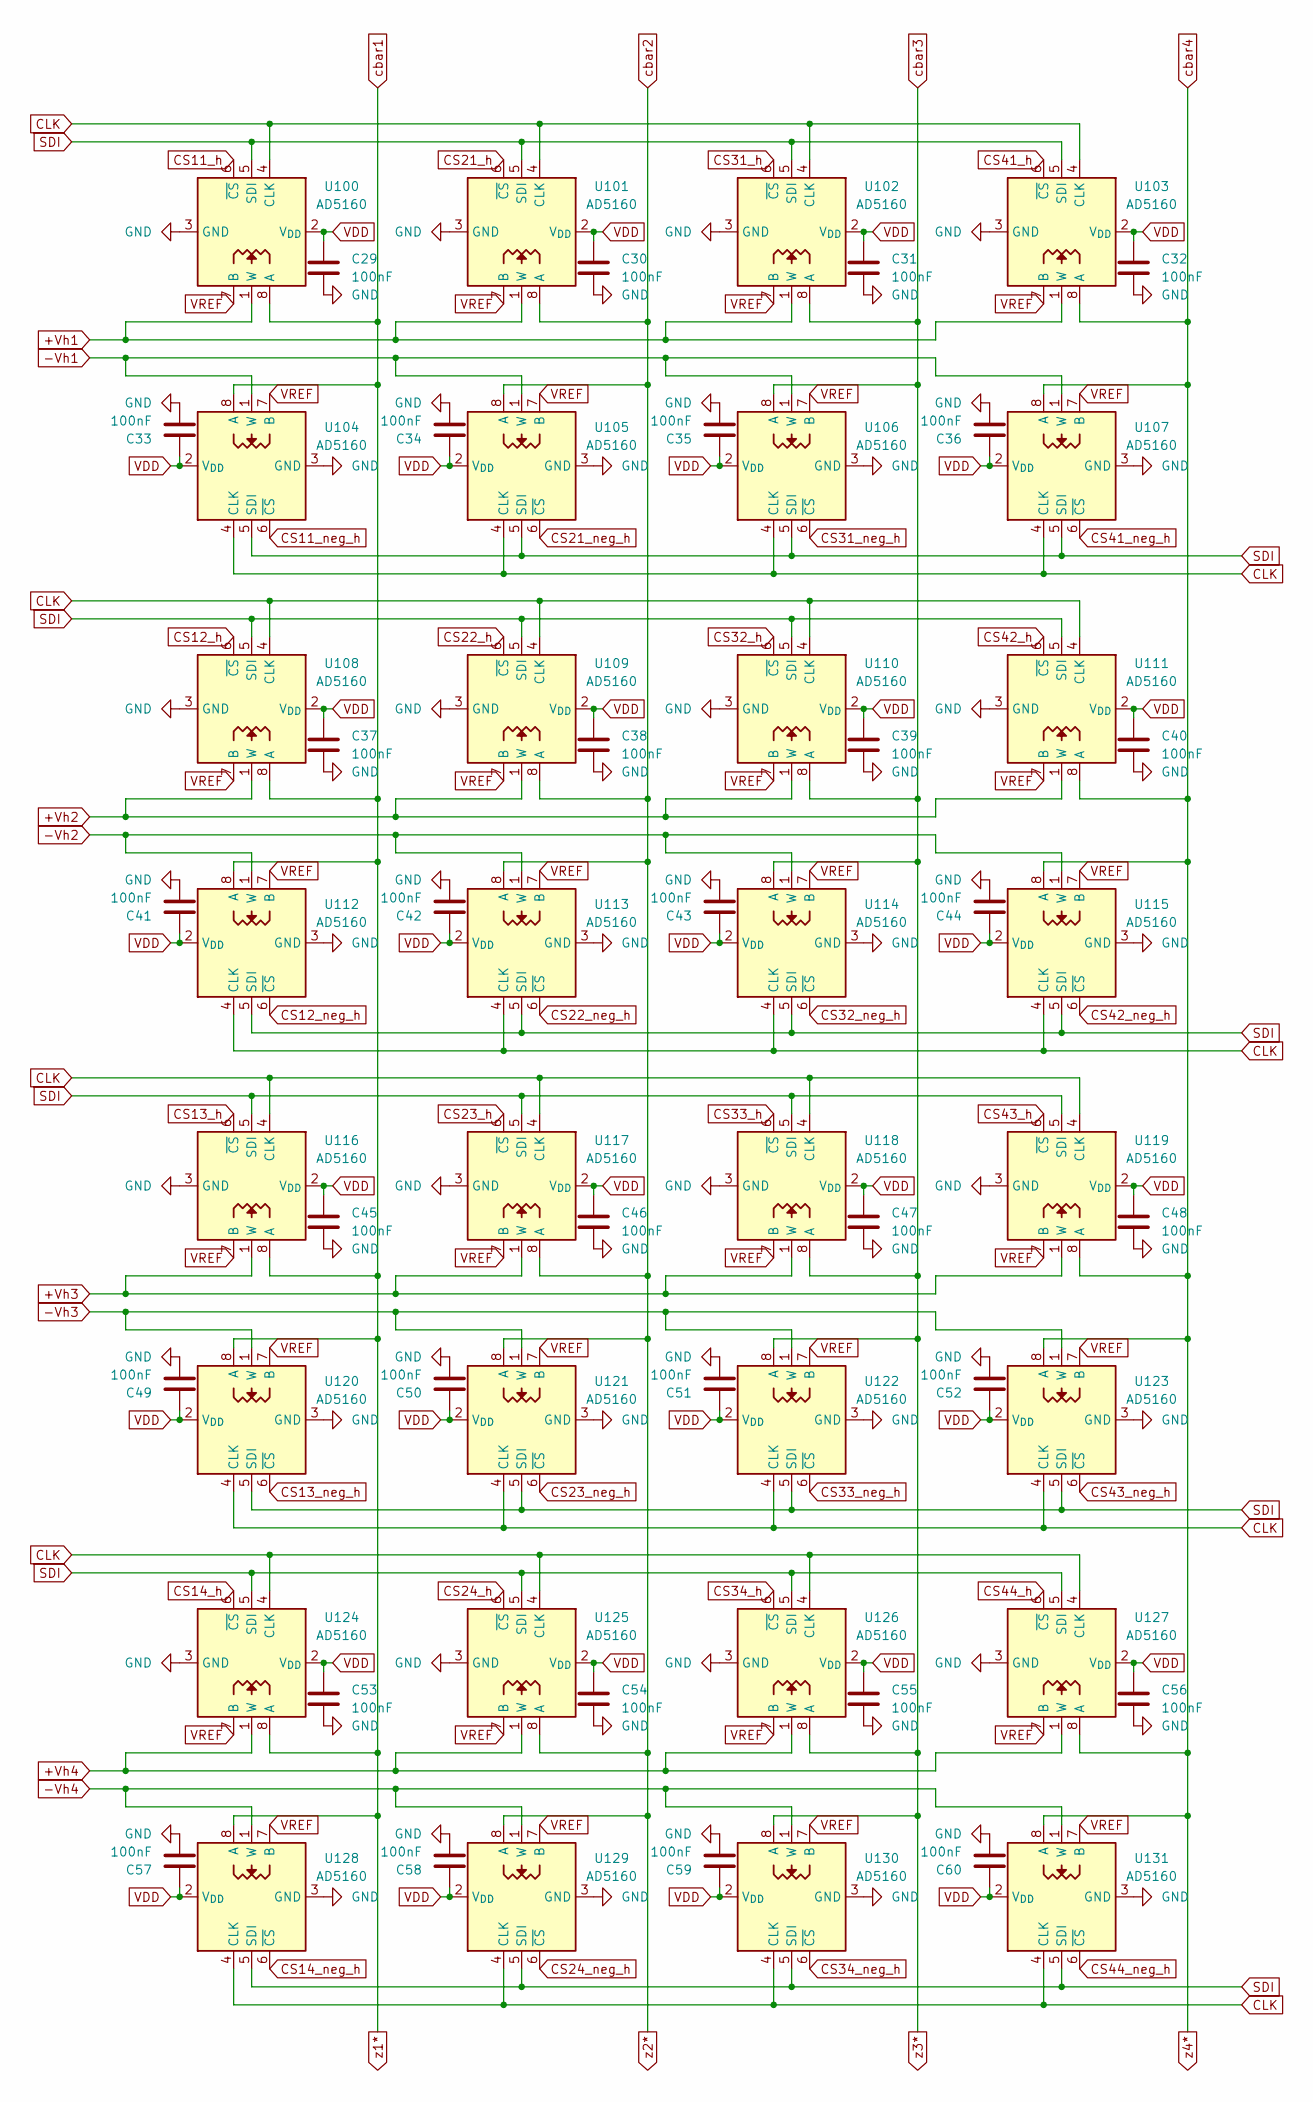
[picture p7: schematic crossbar_h.kicad_sch]

Parts:
C29, C30, C31, C32, C33, C34, C35, C36, C37, C38, C39, C40, C41, C42, C43, C44, C45, C46, C47, C48, C49, C50, C51, C52, C53, C54, C55, C56, C57, C58, C59, C60: 100nF; C_1206_3216Metric
U100, U101, U102, U103, U104, U105, U106, U107, U108, U109, U110, U111, U112, U113, U114, U115, U116, U117, U118, U119, U120, U121, U122, U123, U124, U125, U126, U127, U128, U129, U130, U131: AD5160; SOT-23-8

Connections:
+Vh1: U100.1 (W), U101.1 (W), U102.1 (W), U103.1 (W)
+Vh2: U108.1 (W), U109.1 (W), U110.1 (W), U111.1 (W)
+Vh3: U116.1 (W), U117.1 (W), U118.1 (W), U119.1 (W)
+Vh4: U124.1 (W), U125.1 (W), U126.1 (W), U127.1 (W)
-Vh1: U104.1 (W), U105.1 (W), U106.1 (W), U107.1 (W); also elsewhere on the board
-Vh2: U112.1 (W), U113.1 (W), U114.1 (W), U115.1 (W); also elsewhere on the board
-Vh3: U120.1 (W), U121.1 (W), U122.1 (W), U123.1 (W); also elsewhere on the board
-Vh4: U128.1 (W), U129.1 (W), U130.1 (W), U131.1 (W); also elsewhere on the board
CLK: U100.4 (CLK), U101.4 (CLK), U102.4 (CLK), U103.4 (CLK), U104.4 (CLK), U105.4 (CLK), U106.4 (CLK), U107.4 (CLK), U108.4 (CLK), U109.4 (CLK), U110.4 (CLK), U111.4 (CLK), U112.4 (CLK), U113.4 (CLK), U114.4 (CLK), U115.4 (CLK), U116.4 (CLK), U117.4 (CLK), U118.4 (CLK), U119.4 (CLK), U120.4 (CLK), U121.4 (CLK), U122.4 (CLK), U123.4 (CLK), U124.4 (CLK), U125.4 (CLK), U126.4 (CLK), U127.4 (CLK), U128.4 (CLK), U129.4 (CLK), U130.4 (CLK), U131.4 (CLK); also elsewhere on the board
CS11_h: U100.6 (~CS); also elsewhere on the board
CS11_neg_h: U104.6 (~CS); also elsewhere on the board
CS12_h: U108.6 (~CS); also elsewhere on the board
CS12_neg_h: U112.6 (~CS); also elsewhere on the board
CS13_h: U116.6 (~CS); also elsewhere on the board
CS13_neg_h: U120.6 (~CS); also elsewhere on the board
CS14_h: U124.6 (~CS); also elsewhere on the board
CS14_neg_h: U128.6 (~CS); also elsewhere on the board
CS21_h: U101.6 (~CS); also elsewhere on the board
CS21_neg_h: U105.6 (~CS); also elsewhere on the board
CS22_h: U109.6 (~CS); also elsewhere on the board
CS22_neg_h: U113.6 (~CS); also elsewhere on the board
CS23_h: U117.6 (~CS); also elsewhere on the board
CS23_neg_h: U121.6 (~CS); also elsewhere on the board
CS24_h: U125.6 (~CS); also elsewhere on the board
CS24_neg_h: U129.6 (~CS); also elsewhere on the board
CS31_h: U102.6 (~CS); also elsewhere on the board
CS31_neg_h: U106.6 (~CS); also elsewhere on the board
CS32_h: U110.6 (~CS); also elsewhere on the board
CS32_neg_h: U114.6 (~CS); also elsewhere on the board
CS33_h: U118.6 (~CS); also elsewhere on the board
CS33_neg_h: U122.6 (~CS); also elsewhere on the board
CS34_h: U126.6 (~CS); also elsewhere on the board
CS34_neg_h: U130.6 (~CS); also elsewhere on the board
CS41_h: U103.6 (~CS); also elsewhere on the board
CS41_neg_h: U107.6 (~CS); also elsewhere on the board
CS42_h: U111.6 (~CS); also elsewhere on the board
CS42_neg_h: U115.6 (~CS); also elsewhere on the board
CS43_h: U119.6 (~CS); also elsewhere on the board
CS43_neg_h: U123.6 (~CS); also elsewhere on the board
CS44_h: U127.6 (~CS); also elsewhere on the board
CS44_neg_h: U131.6 (~CS); also elsewhere on the board
GND: C29.2, C30.2, C31.2, C32.2, C33.2, C34.2, C35.2, C36.2, C37.2, C38.2, C39.2, C40.2, C41.2, C42.2, C43.2, C44.2, C45.2, C46.2, C47.2, C48.2, C49.2, C50.2, C51.2, C52.2, C53.2, C54.2, C55.2, C56.2, C57.2, C58.2, C59.2, C60.2, U100.3 (GND), U101.3 (GND), U102.3 (GND), U103.3 (GND), U104.3 (GND), U105.3 (GND), U106.3 (GND), U107.3 (GND), U108.3 (GND), U109.3 (GND), U110.3 (GND), U111.3 (GND), U112.3 (GND), U113.3 (GND), U114.3 (GND), U115.3 (GND), U116.3 (GND), U117.3 (GND), U118.3 (GND), U119.3 (GND), U120.3 (GND), U121.3 (GND), U122.3 (GND), U123.3 (GND), U124.3 (GND), U125.3 (GND), U126.3 (GND), U127.3 (GND), U128.3 (GND), U129.3 (GND), U130.3 (GND), U131.3 (GND); also elsewhere on the board
SDI: U100.5 (SDI), U101.5 (SDI), U102.5 (SDI), U103.5 (SDI), U104.5 (SDI), U105.5 (SDI), U106.5 (SDI), U107.5 (SDI), U108.5 (SDI), U109.5 (SDI), U110.5 (SDI), U111.5 (SDI), U112.5 (SDI), U113.5 (SDI), U114.5 (SDI), U115.5 (SDI), U116.5 (SDI), U117.5 (SDI), U118.5 (SDI), U119.5 (SDI), U120.5 (SDI), U121.5 (SDI), U122.5 (SDI), U123.5 (SDI), U124.5 (SDI), U125.5 (SDI), U126.5 (SDI), U127.5 (SDI), U128.5 (SDI), U129.5 (SDI), U130.5 (SDI), U131.5 (SDI); also elsewhere on the board
VDD: C29.1, C30.1, C31.1, C32.1, C33.1, C34.1, C35.1, C36.1, C37.1, C38.1, C39.1, C40.1, C41.1, C42.1, C43.1, C44.1, C45.1, C46.1, C47.1, C48.1, C49.1, C50.1, C51.1, C52.1, C53.1, C54.1, C55.1, C56.1, C57.1, C58.1, C59.1, C60.1, U100.2 (V_{DD}), U101.2 (V_{DD}), U102.2 (V_{DD}), U103.2 (V_{DD}), U104.2 (V_{DD}), U105.2 (V_{DD}), U106.2 (V_{DD}), U107.2 (V_{DD}), U108.2 (V_{DD}), U109.2 (V_{DD}), U110.2 (V_{DD}), U111.2 (V_{DD}), U112.2 (V_{DD}), U113.2 (V_{DD}), U114.2 (V_{DD}), U115.2 (V_{DD}), U116.2 (V_{DD}), U117.2 (V_{DD}), U118.2 (V_{DD}), U119.2 (V_{DD}), U120.2 (V_{DD}), U121.2 (V_{DD}), U122.2 (V_{DD}), U123.2 (V_{DD}), U124.2 (V_{DD}), U125.2 (V_{DD}), U126.2 (V_{DD}), U127.2 (V_{DD}), U128.2 (V_{DD}), U129.2 (V_{DD}), U130.2 (V_{DD}), U131.2 (V_{DD}); also elsewhere on the board
VREF: U100.7 (B), U101.7 (B), U102.7 (B), U103.7 (B), U104.7 (B), U105.7 (B), U106.7 (B), U107.7 (B), U108.7 (B), U109.7 (B), U110.7 (B), U111.7 (B), U112.7 (B), U113.7 (B), U114.7 (B), U115.7 (B), U116.7 (B), U117.7 (B), U118.7 (B), U119.7 (B), U120.7 (B), U121.7 (B), U122.7 (B), U123.7 (B), U124.7 (B), U125.7 (B), U126.7 (B), U127.7 (B), U128.7 (B), U129.7 (B), U130.7 (B), U131.7 (B); also elsewhere on the board
cbar1: U100.8 (A), U104.8 (A), U108.8 (A), U112.8 (A), U116.8 (A), U120.8 (A), U124.8 (A), U128.8 (A); also elsewhere on the board
cbar2: U101.8 (A), U105.8 (A), U109.8 (A), U113.8 (A), U117.8 (A), U121.8 (A), U125.8 (A), U129.8 (A); also elsewhere on the board
cbar3: U102.8 (A), U106.8 (A), U110.8 (A), U114.8 (A), U118.8 (A), U122.8 (A), U126.8 (A), U130.8 (A); also elsewhere on the board
cbar4: U103.8 (A), U107.8 (A), U111.8 (A), U115.8 (A), U119.8 (A), U123.8 (A), U127.8 (A), U131.8 (A); also elsewhere on the board

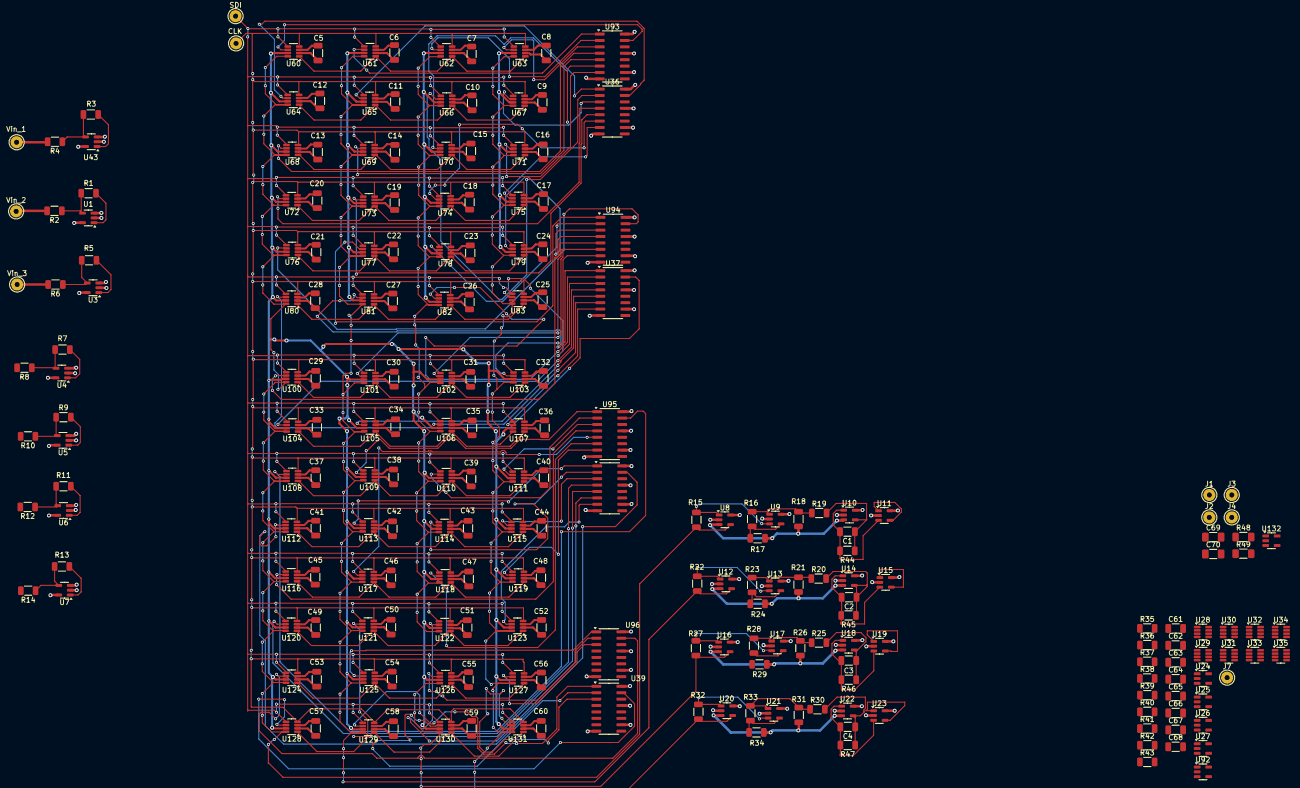
[picture p8: board analog_NN.kicad_pcb from above]

Board: 4 copper layers, 230 parts (0 on the bottom side), 146 nets.

Other parts of the board:
CLK: Conn_01x01; WireSolderPad_1.0mm
SDI: Conn_01x01; WireSolderPad_1.0mm
Vin_1, Vin_2, Vin_3: Conn_01x01; WireSolderPad_1.0mm

Their connections:
CLK: CLK.1; also elsewhere on the board
SDI: SDI.1; also elsewhere on the board
Vu1: Vin_1.1; also elsewhere on the board
Vu2: Vin_2.1; also elsewhere on the board
Vu3: Vin_3.1; also elsewhere on the board
