JoonSJPK/analog_NN/(commit log)

2026-07-11 Before 10K resistors change
    [analog_NN.kicad_pcb, op_amps.kicad_sch, power.kicad_sch, torque.kicad_sch, u_input.kicad_sch]
2026-07-11 Before capcitor update
    [op_amps.kicad_sch, power.kicad_sch, torque.kicad_sch, u_input.kicad_sch]
2026-07-11 updated capacitor values
    [crossbar_h.kicad_sch, crossbar_u.kicad_sch, op_amps.kicad_sch, power.kicad_sch, torque.kicad_sch]
2026-07-11 Updated: power
    [crossbar_h.kicad_sch, crossbar_u.kicad_sch, op_amps.kicad_sch, power.kicad_sch, shift_register_chain.kicad_sch, torque.kicad_sch, u_input.kicad_sch]
2026-07-11 Updated: op amps
    [crossbar_h.kicad_sch, crossbar_u.kicad_sch, op_amps.kicad_sch, power.kicad_sch, torque.kicad_sch, u_input.kicad_sch]
2026-07-11 Updated: pots
    [crossbar_h.kicad_sch, crossbar_u.kicad_sch, op_amps.kicad_sch, power.kicad_sch, torque.kicad_sch, u_input.kicad_sch]
2026-07-11 Updated: components
    [op_amps.kicad_sch, power.kicad_sch, torque.kicad_sch, u_input.kicad_sch]
2026-07-23 Updated: crossbar
    [analog_NN.kicad_pcb, analog_NN.kicad_sch, crossbar_h.kicad_sch, crossbar_u.kicad_sch, op_amps.kicad_sch, power.kicad_sch, power_ext.kicad_sch, shift_register_chain.kicad_sch]
2026-07-23 Updated: crossbar error
    [op_amps.kicad_sch, power_ext.kicad_sch]
2026-07-24 Updated: sim folder
    [analog_NN_JLCPCB_BOM.csv]
2026-07-28 Updated: schematic
    [analog_NN.kicad_pcb, shift_register_chain.kicad_sch]
2026-07-28 Updated: pcb
    [analog_NN.kicad_pcb]
2026-07-29 Updated: cross bar
    [analog_NN.kicad_pcb]
2026-08-01 Updeated: pcb tracing
    [analog_NN.kicad_pcb, u_input.kicad_sch]
2026-08-01 Updated: pcb tracing
2026-08-01 Fixed: v closed loop
    [op_amps.kicad_sch, torque.kicad_sch]
2026-08-03 Updated: export material
    [analog_NN-B_Cu.gbr, analog_NN-B_Mask.gbr, analog_NN-B_Paste.gbr, analog_NN-B_Silkscreen.gbr, analog_NN-Edge_Cuts.gbr, analog_NN-F_Cu.gbr, analog_NN-F_Mask.gbr, analog_NN-F_Paste.gbr]
